Zaiwa-linus/Tiny20/tiny20/xiao/tiny20_xiao_trackball_preview.png

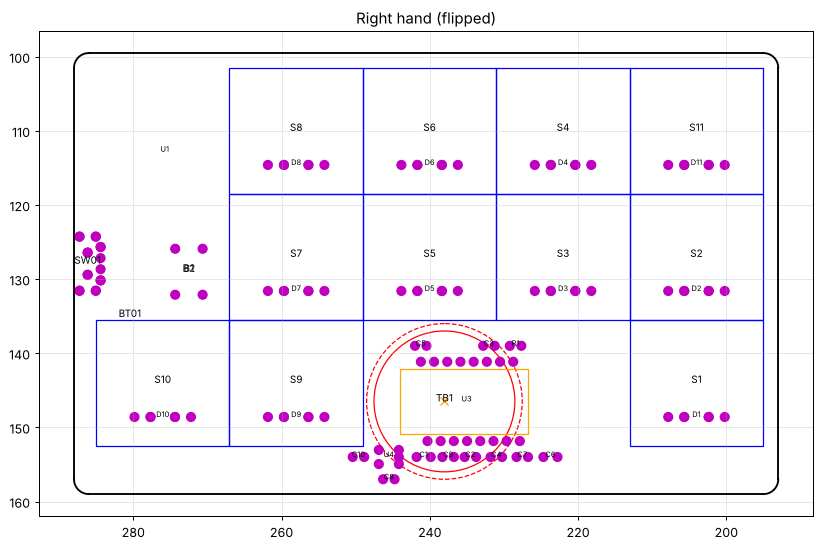
tiny20/xiao/tiny20_xiao_trackball_preview.png
