Zaiwa-linus/Tiny20/tiny20/xiao/tiny20_xiao.kicad_pcb

## KiCad design tiny20/xiao/tiny20_xiao.kicad_pcb (2026-11-03)

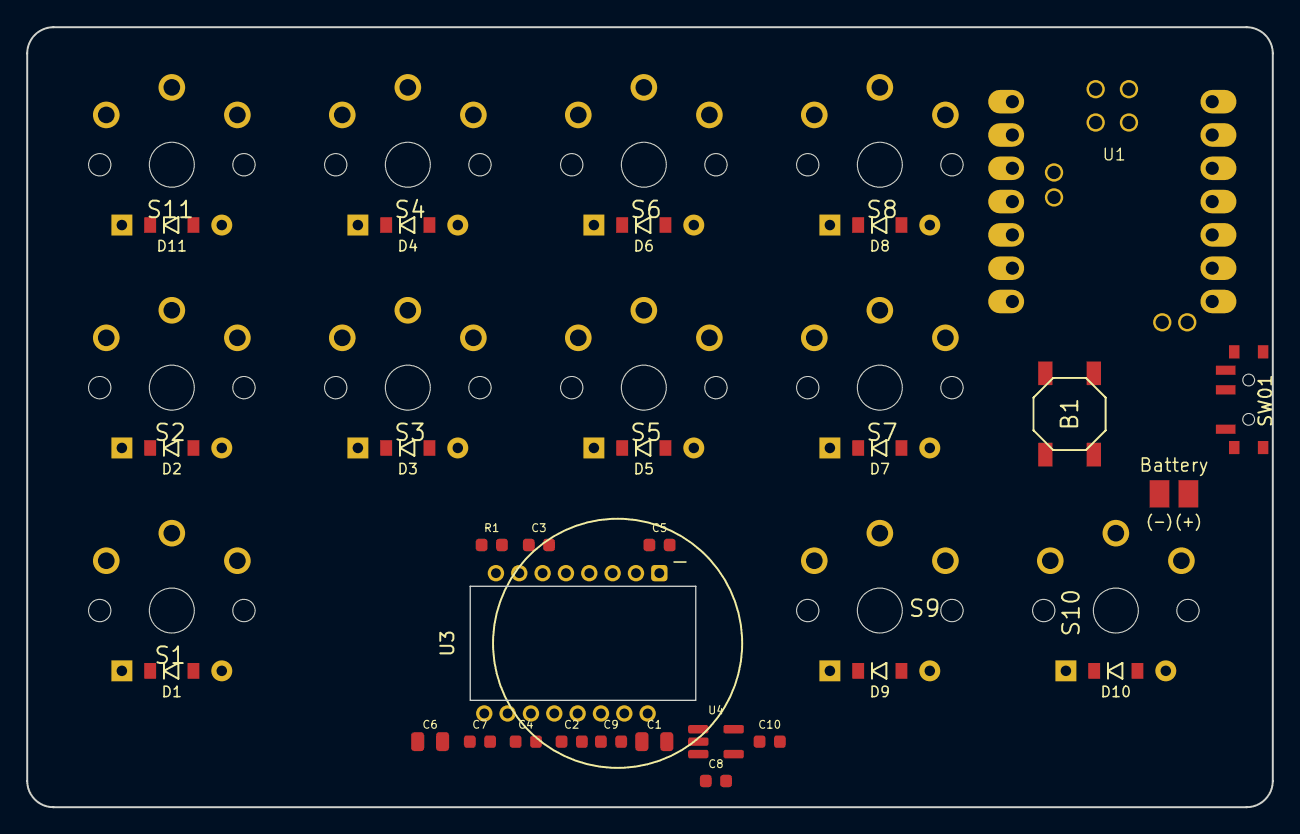
[picture p2: board tiny20_xiao.kicad_pcb from above]

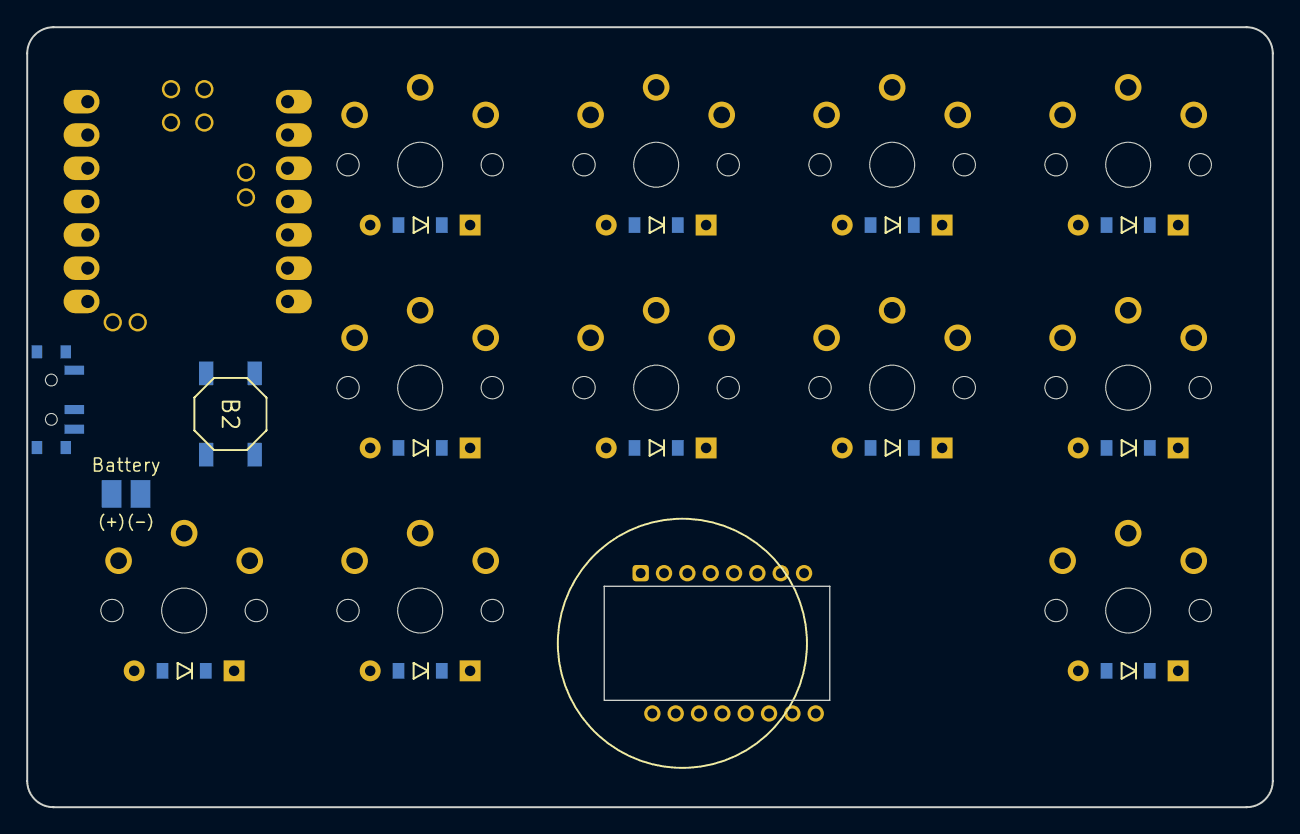
[picture p3: board tiny20_xiao.kicad_pcb from below]

Board: 2 copper layers, 95.0 x 59.5 mm, 41 parts (2 on the bottom side), 36 nets, no tracks yet.

Parts:
B1, B2: SW_TACT_ALPS_SKQGABE010
BT01: Battery_Cell; battery_pads_reversible
C1: 3.3uF; C_0805
C2, C3, C4: 100nF; C_0603
C5, C7: 10nF; C_0603
C6: 10uF; C_0805
C8, C9: 1uF; C_0603
C10: 22nF; C_0603
D1, D2, D3, D4, D5, D6, D7, D8, D9, D10, D11: 1N4148W; D_SOD123_THT_reversible
R1: 10k; R_0603
S1, S2, S3, S4, S5, S6, S7, S8, S9, S10, S11: chocV1_reversible
SW01: SW_SPDT; Power_reversible
TB1: Trackball 19mm; Trackball_19mm
U1: xiao-ble-thruhole; xiao-ble-tht
U3: PMW3610DM-SUDU; PMW3610DM-SUDU_16Pin
U4: TLV74318PDBVR; SOT-23-5_HandSoldering

Connections:
3V3: C3.1, C8.1, R1.1, U1.12, U3.6 (VDDIO), U4.1, U4.3
+1V8: C1.1, C2.1, C9.1, U3.14 (VDD), U4.5
GND: B1.2, B2.2, C1.2, C2.2, C3.2, C5.2, C6.2, C7.2, C8.2, C9.2, C10.2, U1.13, U1.18, U3.11 (GND), U4.2
K_S1: D1.2, S1.1
K_S2: D2.2, S2.1
K_S3: D3.2, S3.1
K_S4: D4.2, S4.1
K_S5: D5.2, S5.1
K_S6: D6.2, S6.1
K_S7: D7.2, S7.1
K_S8: D8.2, S8.1
K_S9: D9.2, S9.1
K_S10: D10.2, S10.1
K_S11: D11.2, S11.1
P1: D4.1, D6.1, D8.1, D11.1, U1.1
P2: D2.1, D3.1, D5.1, D7.1, U1.2
P3: D1.1, D9.1, D10.1, U1.3
P4: S1.2, S2.2, S11.2, U1.4
P5: S3.2, S4.2, S10.2, U1.5
P6: S5.2, S6.2, U1.6
P7: S7.2, S8.2, S9.2, U1.7
P8: U1.8, U3.3 (SCLK)
P9: U1.9, U3.2 (SDIO)
P10: U1.10, U3.8 (MOTION)
P11: U1.11, U3.5 (NCS)
P19: SW01.3, U1.19
P20: BT01.2, U1.20
RST: B1.1, B2.1, U1.17
TB_CN: C4.2, U3.13 (CN)
TB_CP: C4.1, U3.12 (CP)
TB_NR: C10.1, U4.4
TB_NRESET: R1.2, U3.7 (NRESET)
TB_VCP: C6.1, C7.1, U3.9 (VCP)
TB_VCSEL+: C5.1, U3.1 (+VCSEL), U3.10 (PASS_T)
TB_VCSEL-: U3.15 (XYLASER), U3.16 (-VCSEL)
pm: BT01.1, SW01.2
