Zaiwa-linus/Tiny20/(commit log)

2026-11-03 Add right-hand trackball placement to xiao PCB
    Place a trackball footprint (TB1) next to S9 on the right-hand side
    (flipped board), between S9, S5 and S1. Includes ball outline, holder
    keep-out, 3x M2 mounting holes and a 1x6 sensor header. Bottom edge
    arc lowered slightly to fit the holder.
    Claude-Session: https://claude.ai/code/session_01FA75VzhQQnorhx2KmsUkbi
    [tiny20_xiao.kicad_pcb]
2026-11-03 Make xiao PCB ortholinear and move trackball below S3/S5
    - Align keys on an 18x17mm grid: S4/S6/S8 top row, S2/S3/S5/S7 middle
    row, S1 under S2, S9 directly under S7, S10 next to S9
    - Pinky column no longer rotated
    - Trackball (TB1) centered between S3 and S5 with 4mm gap to the keys,
    holes/header kept clear of switches
    - New rounded rectangular outline with a bump for the trackball
    - Remove old routing and zone fills (needs re-routing / refill)
    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
    [tiny20_xiao.kicad_pcb]
2026-11-03 Switch trackball to 1U 14mm module (LiNEA40/LisM style)
    - TB1 now occupies a 1U slot (18x17) on row 3 under S3/S5
    - 14mm ball, 14x8mm PAW3222/PMW3610 sensor module outline
    - 6pin 0.5mm FPC connector (3V3/CS/MOTION/SDIO/SCLK/GND) with new
    TB_* nets (not yet connected to the MCU)
    - Board outline back to a plain rounded rectangle (no bump)
    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
    [tiny20_xiao.kicad_pcb]
2026-11-03 Trackball: 19mm ball right of S9, below S5
    - TB1 moved next to S9 / under S5 (right-hand view), 0.5mm clear of
    the S9 and S5 keycaps with a 21mm case keep-out
    - Ball outline 19mm, sensor module 14x8mm and 6pin FPC kept
    - Bottom board edge extended to fit the case
    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
    [tiny20_xiao.kicad_pcb]
2026-11-03 Move S9/S10 down 0.5mm to clear S7
    Rotated thumb keys are 18mm tall, so the 17mm row pitch made their
    keycap frames overlap S7 by 0.5mm.
    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
    [tiny20_xiao.kicad_pcb]
2026-11-03 Unrotate thumb keys S9/S10 and put them on the grid
    - S9 directly under S7 (17mm), S10 next to it (18mm), both 0deg
    - Trackball re-placed 0.5mm clear of S9's new keycap edge
    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
    [tiny20_xiao.kicad_pcb]
2026-11-03 Add 1xAAA battery holder with boost converter
    - BT1: 1xAAA PCB holder (50x13mm class) left of S10 in right-hand view;
    board widened to x=302.5
    - U2: generic 1x4 step-up module footprint (VIN/GND/VOUT/EN),
    VOUT -> XIAO 3V3
    - Power path: AAA+ -> SW01 -> VBOOST_IN -> U2 -> 3V3
    - SW01 moved to the top edge above the holder
    - LiPo pads BT01 removed (XIAO BAT pads left unconnected)
    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
    [tiny20_xiao.kicad_pcb]
2026-11-03 Revert "Add 1xAAA battery holder with boost converter"
    No in-stock controller with a built-in boost (BMP Boost), so go back to
    the LiPo setup: BT01 pads, SW01 on the right edge, original board width.
    This reverts commit 44a1470.
    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
    [tiny20_xiao.kicad_pcb]
2026-11-03 Remove TRRS jack, add S11, move reset next to the XIAO
    - ZMK BLE split needs no TRRS; jack removed
    - S11 added above S2 (pinky top row) on P1, freed from the TRRS
    - Reset buttons B1/B2 moved from the pinky area to just below the XIAO
    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
    [tiny20_xiao.kicad_pcb]
2026-11-03 Remove S11 to keep direct-pin wiring
    P1 is free again.
    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
    [tiny20_xiao.kicad_pcb]
2026-11-03 Switch to a 3x4 diode matrix, add S11, wire trackball to freed pins
    - S11 back above S2
    - Keys on a col2row matrix: rows P1-P3, cols P4-P7, one diode per key
    (D1-D11, SOD-123 on either side or THT, under each switch)
    - Trackball FPC: SCLK=P8, SDIO=P9, MOTION=P10, CS=P11
    - TB_* placeholder nets removed
    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
    [tiny20_xiao.kicad_pcb]
2026-11-03 Make XIAO footprint ConThrough-ready, drop external reset
    - U1 pins 1-14: round 1.7mm pads, 1.0mm holes centered on the 2.54mm
    grid (castellation offset removed) for ConThrough sockets
    - Removed SWD/RST/GND/NFC bottom-pad holes a socketed XIAO can't reach;
    BAT+/BAT- wire holes kept for the LiPo leads
    - Removed reset buttons B1/B2 (RST is a bottom pad; use the XIAO's
    on-board reset)
    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
    [tiny20_xiao.kicad_pcb]
2026-11-03 Revert ConThrough XIAO footprint, back to direct solder
    Battery (and reset) are only on the XIAO's bottom pads, so like roBa,
    LiNEA40 etc. the XIAO is soldered directly with through-holes over the
    bottom pads. Restores the original footprint and reset buttons B1/B2.
    This reverts commit c3d6215.
    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
    [tiny20_xiao.kicad_pcb]
2026-11-03 Widen board right edge, settle on PAW3222 sensor module
    - Right edge 285.53 -> 288.0 (S10 keycap now ~3mm from the edge);
    power switch moved with the edge
    - Trackball footprint: nogikes 14x8mm PAW3222 module, 6pin 0.5mm FPC
    (opposite-side-contact FFC keeps pin order)
    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
    [tiny20_xiao.kicad_pcb]
2026-11-03 Trackball sensor: PMW3610 mounted directly on the PCB (LiNEA40 style)
    - U3 PMW3610DM-SUDU in a PCB cutout, optical center under the 19mm ball;
    footprint geometry from siderakb/pmw3610-pcb (CERN-OHL-P v2)
    - Support circuit per that reference: U4 TLV74318 1.8V LDO (VDD),
    VDDIO = 3V3, C1-C10, R1 NRESET pull-up, all 0603/0805 on F.Cu
    - SPI: SCLK=P8, SDIO=P9, MOTION=P10, NCS=P11
    - FPC module footprint removed; TB1 is now ball/case outline only
    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
    [tiny20_xiao.kicad_pcb]
