Zaiwa-linus/Tiny20/(notices)

Notices in the files:
parts and their libraries:
PMW3610DM-SUDU molded lead-frame DIP in a PCB cutout, LM18-LSI lens. Optical center at (2.988,0). Geometry from siderakb/pmw3610-pcb (CERN-OHL-P v2).
